omeralaa11/BLDC-Motor-controller-for-Shell-eco-marathon-/README.md

# BLDC-Motor-controller-for-Shell-eco-marathon-
Hardware design of A BLDC Motor controller design for a 350W motor used in Shell eco marathon Qatar 2026 competition
