omeralaa11/BLDC-Motor-controller-for-Shell-eco-marathon-/REF/Ref designs for controller hardware.docx

Ref designs for shell controller hardware

- https://github.com/pgrady3/EasyController3/tree/main
- https://vesc-project.com/
- https://odriverobotics.com/
- https://github.com/HugoBrunner/E-Comet-Software-for-Shell-Eco-Marathon/tree/master
- https://github.com/AlkaMotors/f051bldc
- https://github.com/pgrady3/EasyController2
- https://github.com/EFeru/hoverboard-firmware-hack-FOC?tab=readme-ov-file#hardware
- https://www.youtube.com/watch?v=Rgaq5ax71fE
- https://simple-circuit.com/arduino-brushless-dc-motor-controller/
- https://www.mouser.com/pdfDocs/Essential_Guide_to_Brushless_DC_Motor_Controls041921.pdf
- https://thinkrobotics.com/blogs/learn/bldc-motor-controller-design-complete-engineering-guide-for-brushless-dc-motor-controllers-in-2025
- https://www.integrasources.com/blog/bldc-motor-controller-design-principles/
- https://resources.altium.com/p/build-advanced-brushless-motor-controller
- https://www.elektormagazine.com/articles/a-beginner-s-guide-to-controlling-bldc-motors
- https://www.instructables.com/Make-Your-Own-Sensored-ESC/
