omeralaa11/BLDC-Motor-controller-for-Shell-eco-marathon-/Images & Pics/Controller V2_2.jpg

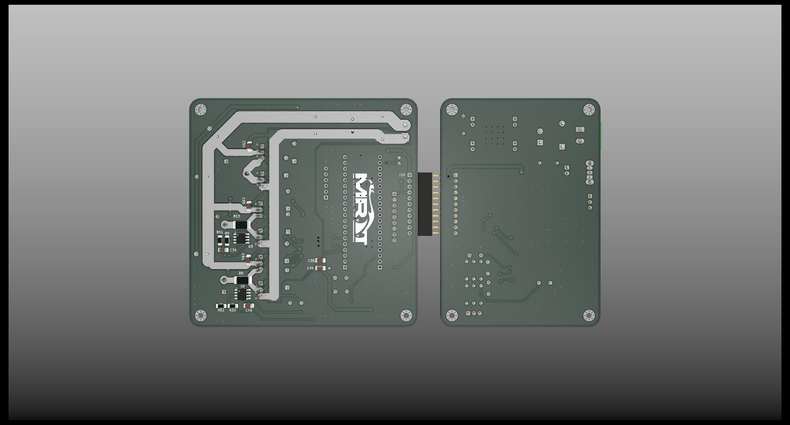
Images & Pics/Controller V2_2.jpg
