omeralaa11/BLDC-Motor-controller-for-Shell-eco-marathon-/Images & Pics/WhatsApp Image 2026-02-10 at 7.59.01 PM (1).jpeg

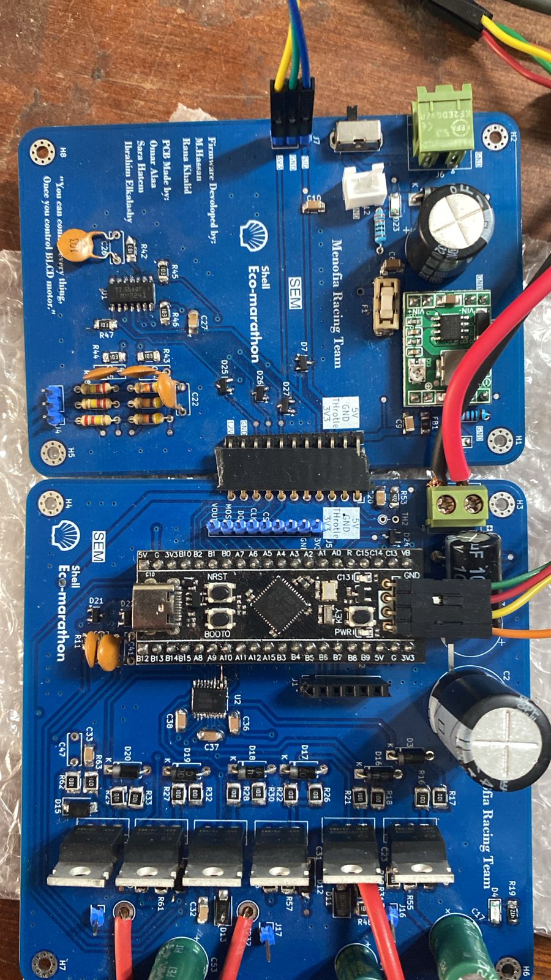
Images & Pics/WhatsApp Image 2026-02-10 at 7.59.01 PM (1).jpeg
