omeralaa11/BLDC-Motor-controller-for-Shell-eco-marathon-/3D models/D-SUN_dcdc_step_down_SIMPLE.step

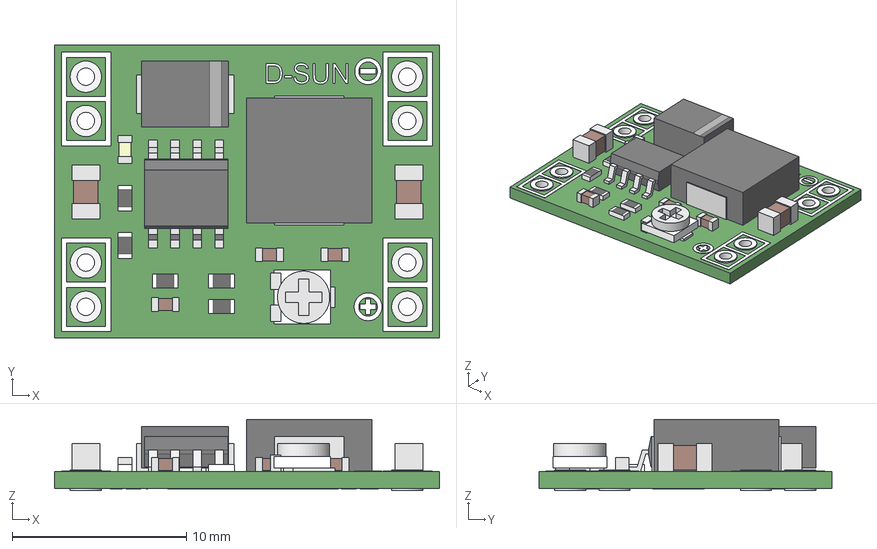
[picture p17: CAD file, 2026-03-26]
3D models/D-SUN_dcdc_step_down_SIMPLE.step
22.1 x 16.8 x 4.10 mm
main001
silk-TOP
pins
silk-bot
comp-top
