omeralaa11/BLDC-Motor-controller-for-Shell-eco-marathon-/3D models/SMD fuse holder v7.step

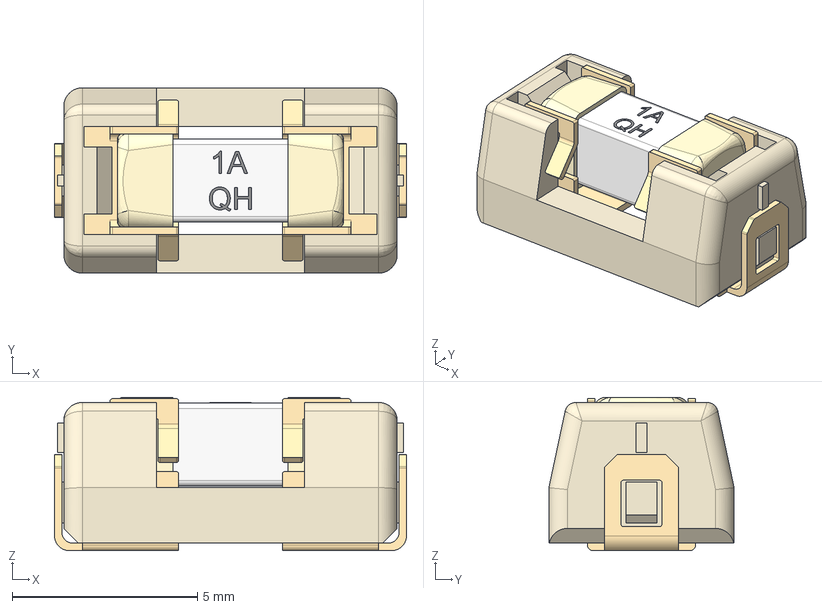
[picture p18: CAD file, 2026-03-26]
3D models/SMD fuse holder v7.step
9.50 x 5.00 x 4.14 mm
0679H1000-xxsingle fonts v2
Terminal
