omeralaa11/BLDC-Motor-controller-for-Shell-eco-marathon-/3D models/DRV8300DPWR.step

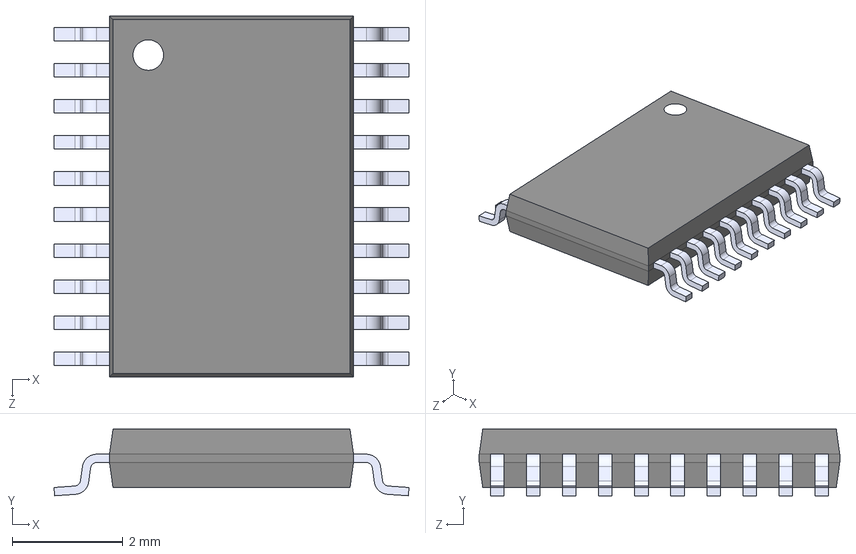
[picture p19: CAD file, 2026-03-26]
3D models/DRV8300DPWR.step
6.40 x 1.20 x 6.50 mm
