omeralaa11/BLDC-Motor-controller-for-Shell-eco-marathon-/3D models/703W-00_52.step

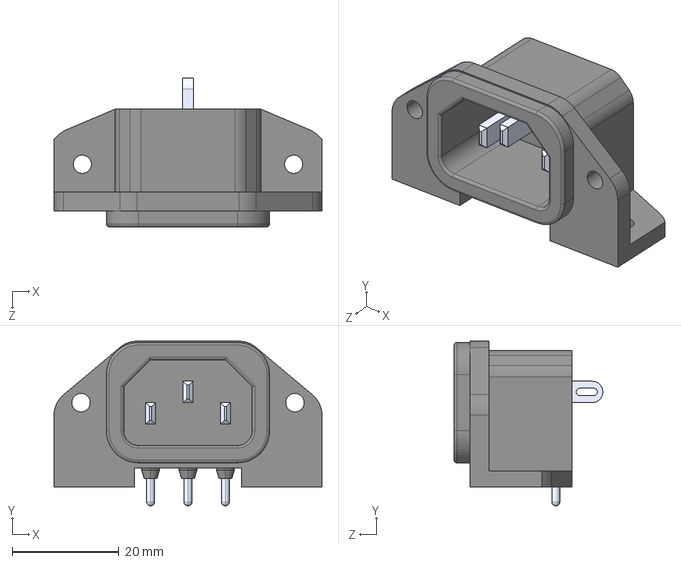
[picture p20: CAD file, 2026-03-26]
3D models/703W-00_52.step
50.1 x 30.8 x 27.8 mm
