omeralaa11/BLDC-Motor-controller-for-Shell-eco-marathon-/3D models/Controller V2.step

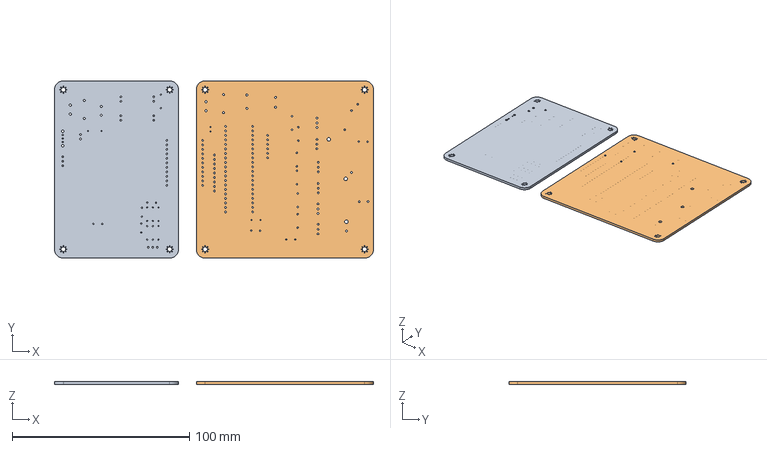
[picture p21: CAD file, 2026-03-26]
3D models/Controller V2.step
180.0 x 100.0 x 1.51 mm
Controller V2_PCB_1
Controller V2_PCB_2
