omeralaa11/BLDC-Motor-controller-for-Shell-eco-marathon-/3D models/DRV8303DCA.step

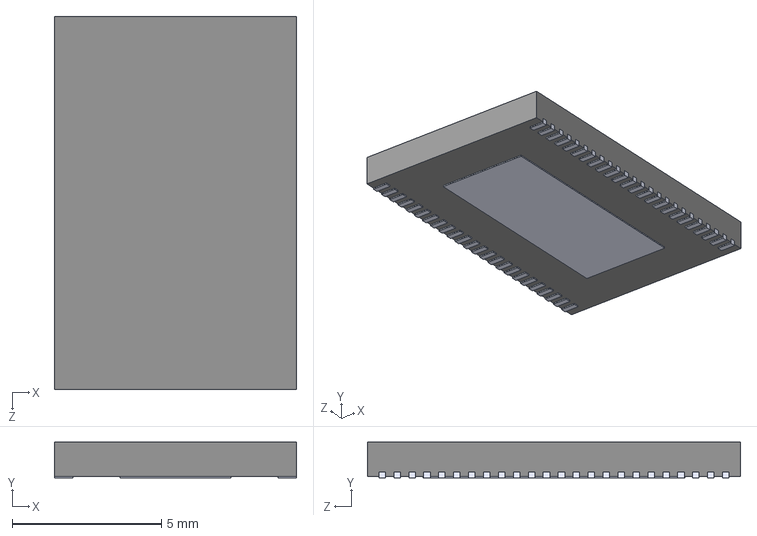
[picture p22: CAD file, 2026-03-26]
3D models/DRV8303DCA.step
8.10 x 1.20 x 12.5 mm
