omeralaa11/BLDC-Motor-controller-for-Shell-eco-marathon-/Documents/Controller  V2.pdf

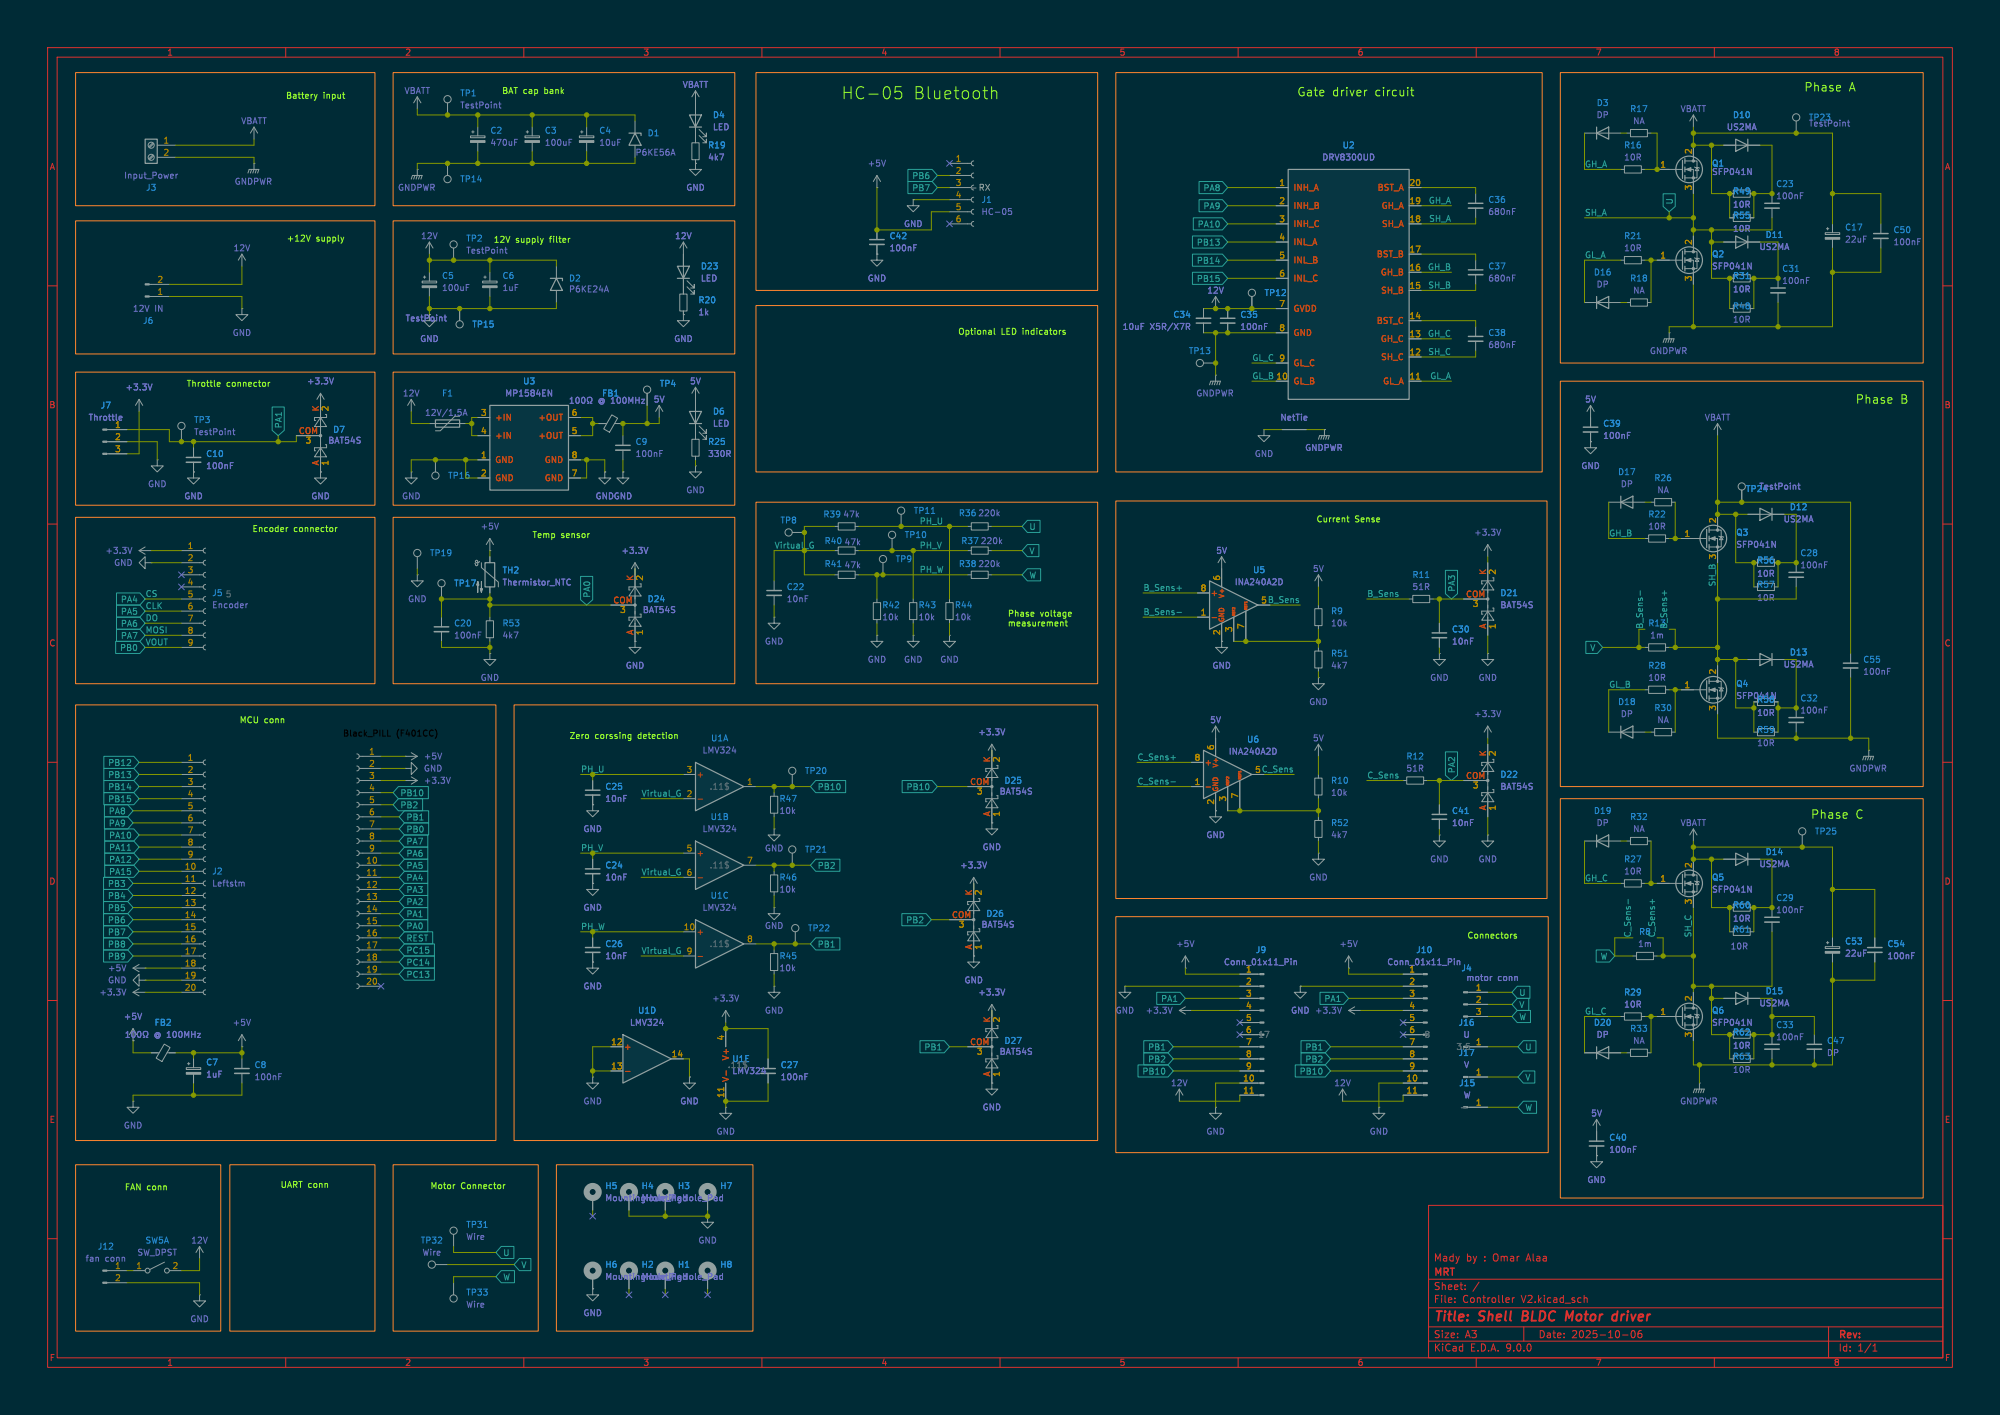
[picture p23: page 1]

Temp sensor Motor Connector
