omeralaa11/BLDC-Motor-controller-for-Shell-eco-marathon-/(list of files, drawings)

Other design files:
Simulation & analysis/code_test0.pdsprj
Simulation & analysis/Current Sensor new2.pdsprj
Simulation & analysis/Current Sensor new.pdsprj
Simulation & analysis/dead time.pdsprj
Simulation & analysis/Zero Crossing Simulation2.pdsprj
Simulation & analysis/Zero Crossing Simulation.pdsprj
