omeralaa11/BLDC-Motor-controller-for-Shell-eco-marathon-/PCB/Controller V2.kicad_sch

## KiCad design PCB/Controller V2.kicad_sch (2026-03-26)

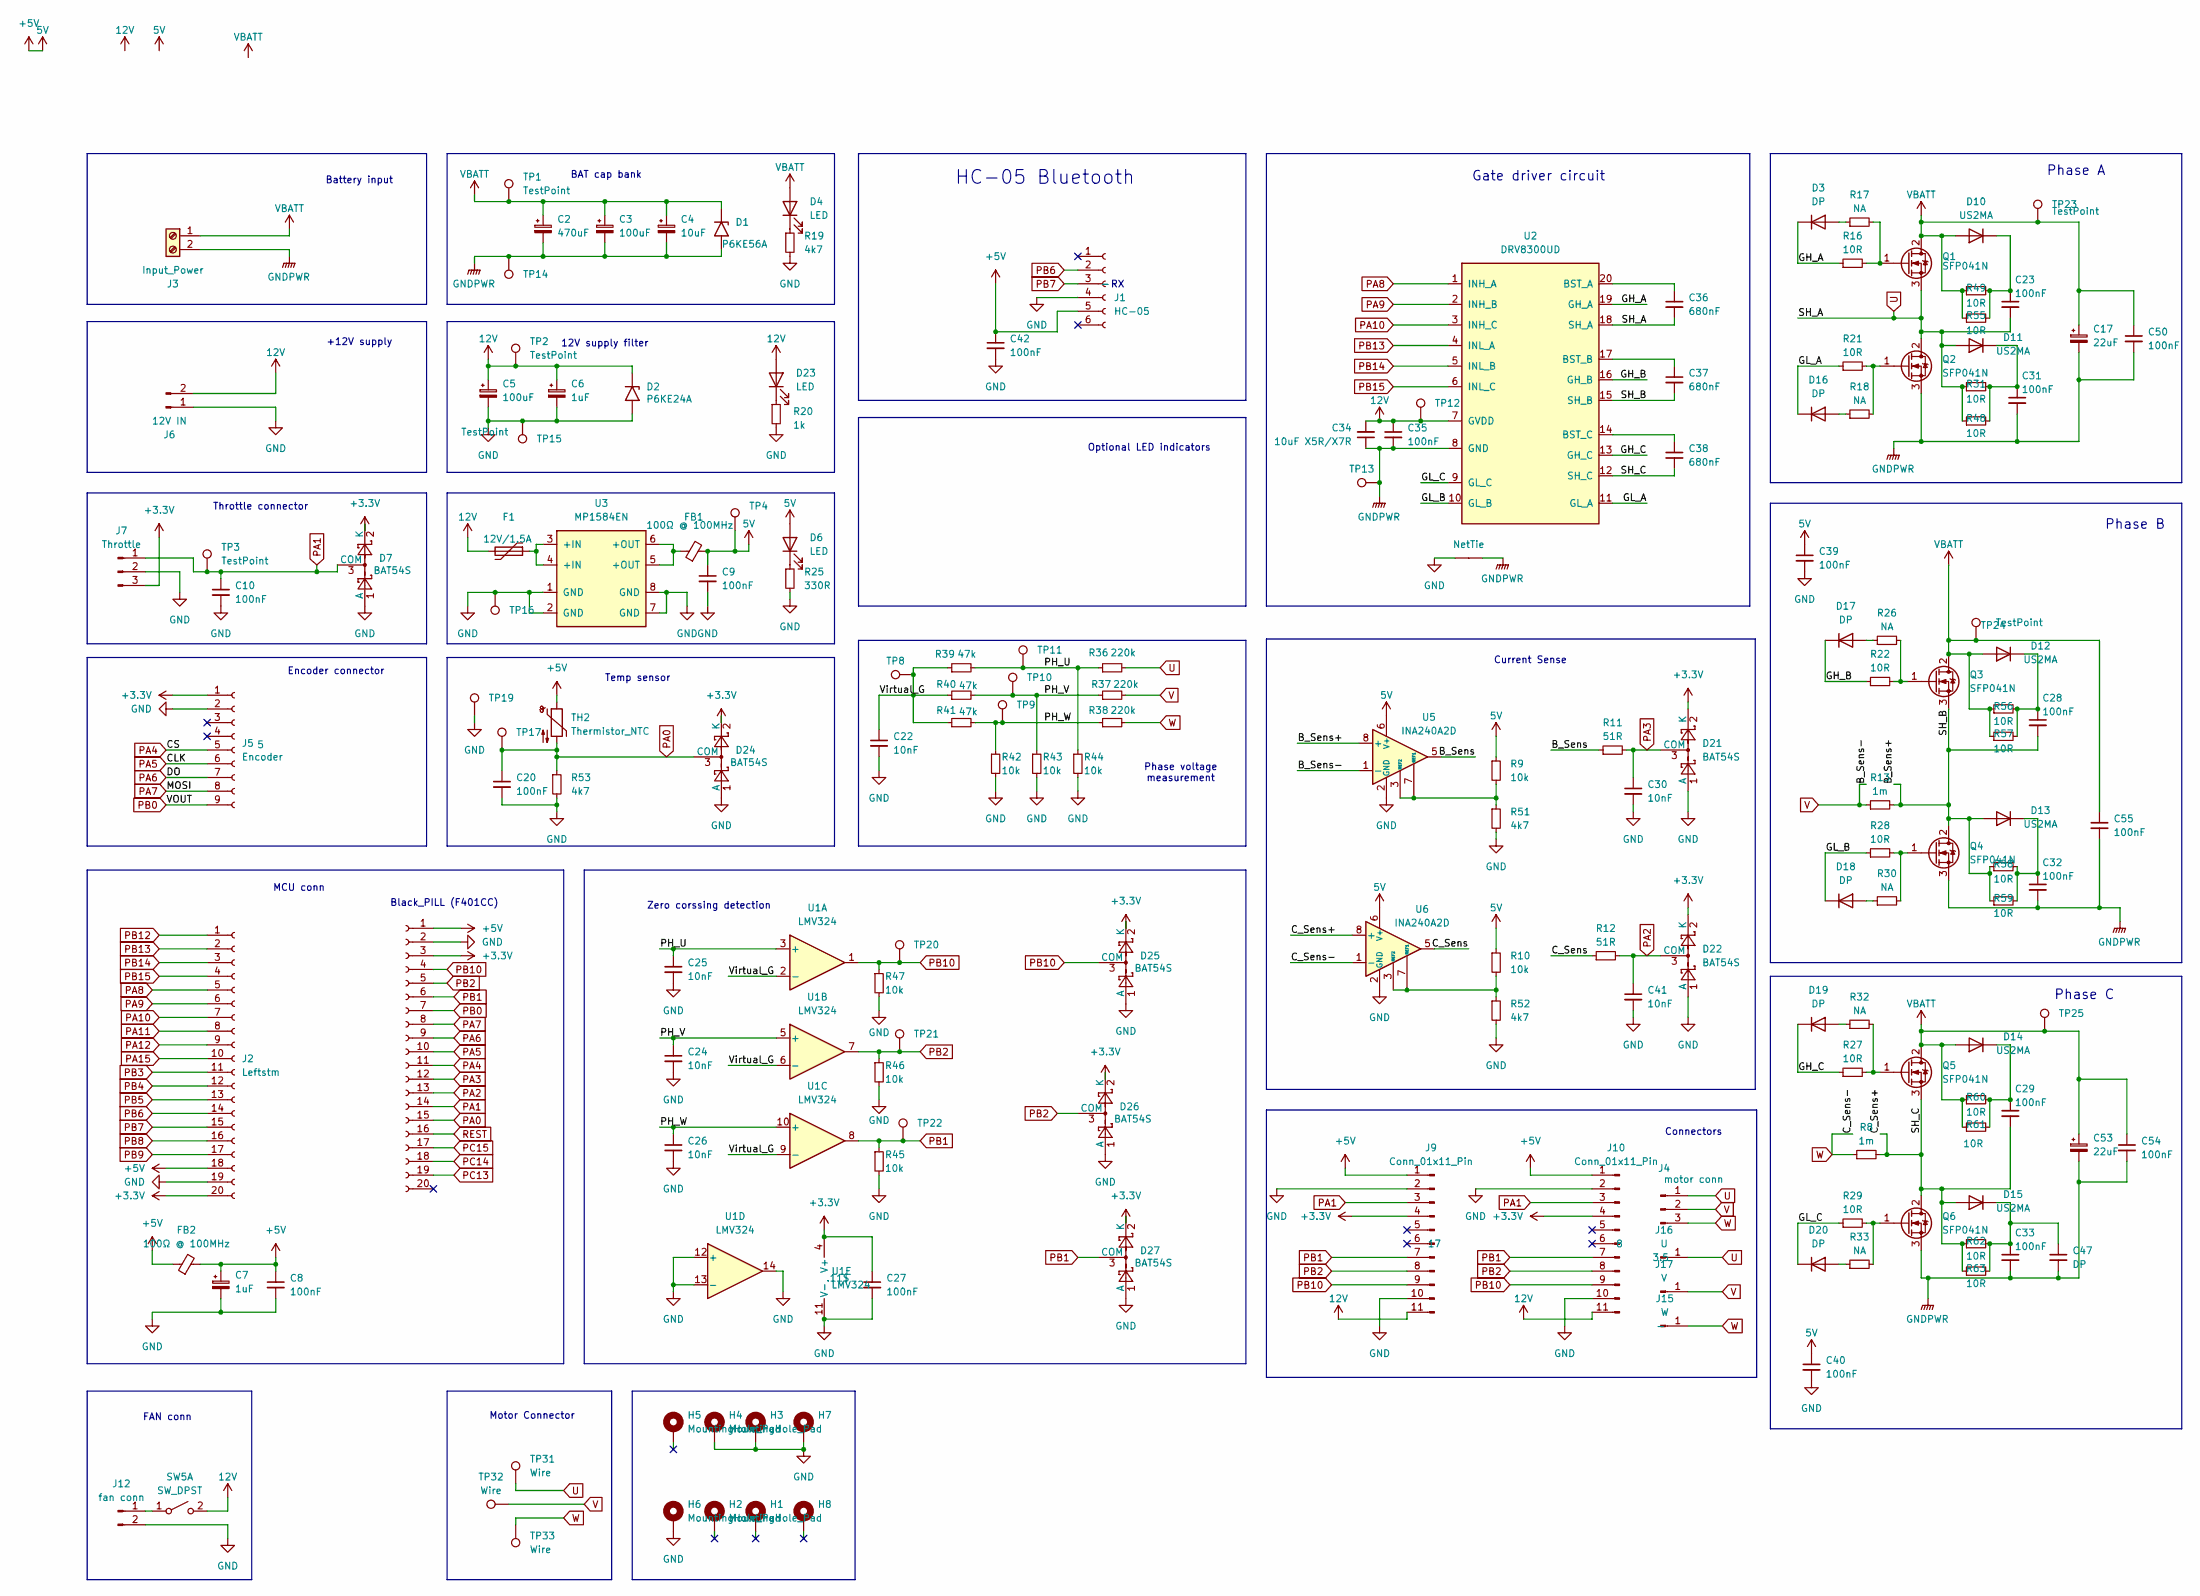
[picture p24: schematic Controller V2.kicad_sch]

Parts:
C2: 470uF; CP_Radial_D16.0mm_P7.50mm
C3, C5: 100uF; CP_Radial_D12.5mm_P5.00mm
C4: 10uF; CP_Radial_D8.0mm_P5.00mm
C6, C7: 1uF; C_1206_3216Metric_Pad1.33x1.80mm_HandSolder
C8, C9, C10, C20, C23, C27, C28, C29, C31, C32, C33, C35, C39, C40, C42, C50, C54, C55: 100nF; C_1206_3216Metric_Pad1.33x1.80mm_HandSolder
C17, C53: 22uF; CP_Radial_D10.0mm_P5.00mm
C22, C24, C25, C26, C30, C41: 10nF; C_Disc_D6.0mm_W2.5mm_P5.00mm
C34: 10uF X5R/X7R; C_1206_3216Metric_Pad1.33x1.80mm_HandSolder
C36, C37, C38: 680nF; C_1206_3216Metric_Pad1.33x1.80mm_HandSolder
C47: DP; C_Disc_D6.0mm_W2.5mm_P5.00mm
D1: P6KE56A; D_DO-15_P10.16mm_Horizontal
D2: P6KE24A; D_DO-15_P10.16mm_Horizontal
D3, D16, D17, D18, D19, D20: DP; D_A-405_P7.62mm_Horizontal
D4, D6, D23: LED; LED_1206_3216Metric_Pad1.42x1.75mm_HandSolder
D7, D21, D22, D24, D25, D26, D27: BAT54S; SOT-23
D10, D11, D12, D13, D14, D15: US2MA; D_SMA
F1: 12V/1.5A; Fuse_2512_6332Metric
FB1, FB2: 100Ω @ 100MHz; L_1206_3216Metric_Pad1.42x1.75mm_HandSolder
H1, H2, H3, H4, H5, H6, H7, H8: MountingHole_Pad; MountingHole_2.5mm_Pad_Via
J1: HC-05; PinSocket_1x06_P2.54mm_Vertical
J2, J11: Leftstm; PinSocket_1x20_P2.54mm_Vertical
J3: Input_Power; TerminalBlock_Phoenix_MKDS-1,5-2-5.08_1x02_P5.08mm_Horizont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
J4: motor conn; PinHeader_1x03_P2.54mm_Vertical
J5: Encoder; PinHeader_1x09_P2.54mm_Vertical
J6: 12V IN; PhoenixContact_MSTBA_2,5_2-G-5,08_1x02_P5.08mm_Horizontal
J7: Throttle; PinHeader_1x03_P2.54mm_Vertical
J9: Conn_01x11_Pin; PinHeader_1x11_P2.54mm_Horizontal
J10: Conn_01x11_Pin; PinSocket_1x11_P2.54mm_Horizontal
J12: fan conn; JST_EH_B2B-EH-A_1x02_P2.50mm_Vertical
J15: W; PinHeader_1x01_P2.54mm_Vertical
J16: U; PinHeader_1x01_P2.54mm_Vertical
J17: V; PinHeader_1x01_P2.54mm_Vertical
NT1: NetTie; NetTie-2_SMD_Pad0.16mm_6mil; Part Number Do Not Place
Q1, Q2, Q3, Q4, Q5, Q6: SFP041N; TO-220-3_Vertical; Part Number 2 IRFB7545PBF
R8, R13: 1m; R_2512_6332Metric_Pad1.40x3.35mm_HandSolder
R9, R10, R42, R43, R44, R45, R46, R47: 10k; R_1206_3216Metric_Pad1.30x1.75mm_HandSolder
R11, R12: 51R; R_0805_2012Metric_Pad1.20x1.40mm_HandSolder
R16, R21, R22, R27, R28, R29, R31, R48, R49, R55, R56, R57, R58, R59, R60, R61, R62, R63: 10R; R_1210_3225Metric_Pad1.30x2.65mm_HandSolder
R17, R18, R26, R30, R32, R33: NA; R_1210_3225Metric_Pad1.30x2.65mm_HandSolder
R19, R51, R52, R53: 4k7; R_1206_3216Metric_Pad1.30x1.75mm_HandSolder
R20: 1k; R_Axial_DIN0204_L3.6mm_D1.6mm_P7.62mm_Horizontal
R25: 330R; R_Axial_DIN0204_L3.6mm_D1.6mm_P7.62mm_Horizontal
R36, R37, R38: 220k; R_Axial_DIN0204_L3.6mm_D1.6mm_P7.62mm_Horizontal
R39, R40, R41: 47k; R_Axial_DIN0204_L3.6mm_D1.6mm_P7.62mm_Horizontal
SW5: SW_DPST; SW_Slide_SPDT_Straight_CK_OS102011MS2Q
TH2: Thermistor_NTC; R_Axial_DIN0204_L3.6mm_D1.6mm_P2.54mm_Vertical
TP1, TP2, TP3, TP4, TP8, TP9, TP10, TP11, TP12, TP13, TP14, TP15, TP16, TP17, TP19, TP20, TP21, TP22, TP23, TP24, TP25: TestPoint; TestPoint-1.0mm
TP31, TP32, TP33: Wire; TestPoint_Loop_D3.80mm_Drill2.0mm
U1: LMV324; SOIC-14_3.9x8.7mm_P1.27mm
U2: DRV8300UD; SOP65P640X120-20N
U3: MP1584EN; SOP65P640X120-20N
U5, U6: INA240A2D; SOIC-8_3.9x4.9mm_P1.27mm

Connections:
12V: C5.1, C6.1, C34.2, C35.1, D2.1 (A1), D23.2 (A), F1.2, J6.2, J9.11, J10.11, SW5.2 (B), TP2.1, TP12.1, U2.7 (GVDD)
+3.3V: C27.1, D7.2 (K), D21.2 (K), D22.2 (K), D24.2 (K), D25.2 (K), D26.2 (K), D27.2 (K), J2.20, J5.1, J7.3, J9.4, J10.4, J11.3, U1.4 (V+)
+5V: C7.1, C8.1, C9.1, C39.1, C40.1, C42.1, D6.2 (A), FB1.2, FB2.1, FB2.2, J1.5, J2.18, J9.1, J10.1, J11.1, R9.1, R10.1, TH2.1, TP4.1, U5.6 (V+), U6.6 (V+)
B_Sens: R11.1, U5.5
B_Sens+: C28.2, C37.2, D13.2 (A), Q3.3 (S), Q4.2 (D), R13.2, R58.1, R59.1, U2.15 (SH_B), U5.8 (+)
C_Sens: R12.1, U6.5
C_Sens+: C29.2, C38.2, D15.2 (A), Q5.3 (S), Q6.2 (D), R8.2, R62.1, R63.1, U2.12 (SH_C), U6.8 (+)
GH_A: D3.1 (K), R16.1, U2.19 (GH_A)
GH_B: D17.1 (K), R22.1, U2.16 (GH_B)
GH_C: D19.1 (K), R27.1, U2.13 (GH_C)
GL_A: D16.1 (K), R21.1, U2.11 (GL_A)
GL_B: D18.1 (K), R28.1, U2.10 (GL_B)
GL_C: D20.1 (K), R29.1, U2.9 (GL_C)
GND: C5.2, C6.2, C7.2, C8.2, C9.2, C10.2, C20.2, C22.2, C24.2, C25.2, C26.2, C27.2, C30.2, C39.2, C40.2, C41.2, C42.2, D2.2 (A2), D7.1 (A), D21.1 (A), D22.1 (A), D24.1 (A), D25.1 (A), D26.1 (A), D27.1 (A), H3.1, H4.1, H6.1, H7.1, J1.4, J2.19, J5.2, J6.1, J7.2, J9.2, J9.10, J10.2, J10.10, J11.2, J12.2, NT1.1, R19.2, R20.2, R25.2, R42.2, R43.2, R44.2, R45.2, R46.2, R47.2, R51.2, R52.2, R53.2, TP15.1, TP16.1, TP19.1, U1.11 (V-), U1.12 (+), U1.13 (-), U1.14, U3.1 (GND), U3.2 (GND), U3.7 (GND), U3.8 (GND), U5.2 (GND), U5.4 (GND), U6.2 (GND), U6.4 (GND)
GNDPWR: C2.2, C3.2, C4.2, C17.2, C31.2, C32.2, C33.2, C34.1, C35.2, C47.2, C50.2, C53.2, C54.2, C55.2, D1.2 (A2), J3.2, NT1.2, Q2.3 (S), Q4.3 (S), Q6.3 (S), TP13.1, TP14.1, U2.8 (GND)
unnamed: C23.1, D10.1 (K), R49.2, R55.2
unnamed: C28.1, D12.1 (K), R56.2, R57.2
unnamed: C29.1, D14.1 (K), R60.2, R61.2
unnamed: C31.1, D11.1 (K), R31.2, R48.2
unnamed: C32.1, D13.1 (K), R58.2, R59.2
unnamed: C33.1, C47.1, D15.1 (K), R62.2, R63.2
unnamed: C36.1, U2.20 (BST_A)
unnamed: C37.1, U2.17 (BST_B)
unnamed: C38.1, U2.14 (BST_C)
unnamed: D3.2 (A), R17.1
unnamed: D4.1 (K), R19.1
unnamed: D6.1 (K), R25.1
unnamed: D16.2 (A), R18.1
unnamed: D17.2 (A), R26.1
unnamed: D18.2 (A), R30.1
unnamed: D19.2 (A), R32.1
unnamed: D20.2 (A), R33.1
unnamed: D23.1 (K), R20.1
unnamed: F1.1, U3.3 (+IN), U3.4 (+IN)
unnamed: FB1.1, U3.5 (+OUT), U3.6 (+OUT)
unnamed: J12.1, SW5.1 (A)
unnamed: Q1.1 (G), R16.2, R17.2
unnamed: Q2.1 (G), R18.2, R21.2
unnamed: Q3.1 (G), R22.2, R26.2
unnamed: Q4.1 (G), R28.2, R30.2
unnamed: Q5.1 (G), R27.2, R32.2
unnamed: Q6.1 (G), R29.2, R33.2
unnamed: R10.2, R52.1, U6.3 (REF2), U6.7 (REF1)
unnamed: R9.2, R51.1, U5.3 (REF2), U5.7 (REF1)
PA0: C20.1, D24.3 (COM), J11.15, R53.1, TH2.2, TP17.1
PA1: C10.1, D7.3 (COM), J7.1, J9.3, J10.3, J11.14, TP3.1
PA2: C41.1, D22.3 (COM), J11.13, R12.2
PA3: C30.1, D21.3 (COM), J11.12, R11.2
PA4: J5.5, J11.11
PA5: J5.6, J11.10
PA6: J5.7, J11.9
PA7: J5.8, J11.8
PA8: J2.5, U2.1 (INH_A)
PA9: J2.6, U2.2 (INH_B)
PA10: J2.7, U2.3 (INH_C)
PA11: J2.8
PA12: J2.9
PA15: J2.10
PB0: J5.9, J11.7
PB1: D27.3 (COM), J9.7, J10.7, J11.6, R45.1, TP22.1, U1.8
PB2: D26.3 (COM), J9.8, J10.8, J11.5, R46.1, TP21.1, U1.7
PB3: J2.11
PB4: J2.12
PB5: J2.13
PB6: J1.2, J2.14
PB7: J1.3, J2.15
PB8: J2.16
PB9: J2.17
PB10: D25.3 (COM), J9.9, J10.9, J11.4, R47.1, TP20.1, U1.1
PB12: J2.1
PB13: J2.2, U2.4 (INL_A)
PB14: J2.3, U2.5 (INL_B)
PB15: J2.4, U2.6 (INL_C)
PC13: J11.19
PC14: J11.18
PC15: J11.17
PH_U: C25.1, R36.1, R39.2, R44.1, TP11.1, U1.3 (+)
PH_V: C24.1, R37.1, R40.2, R43.1, TP10.1, U1.5 (+)
PH_W: C26.1, R38.1, R41.2, R42.1, TP9.1, U1.10 (+)
REST: J11.16
U: C23.2, C36.2, D11.2 (A), J4.1, J16.1, Q1.3 (S), Q2.2 (D), R31.1, R36.2, R48.1, TP31.1, U2.18 (SH_A)
V: J4.2, J17.1, R13.1, R37.2, TP32.1, U5.1 (-)
VBATT: C2.1, C3.1, C4.1, C17.1, C50.1, C53.1, C54.1, C55.1, D1.1 (A1), D4.2 (A), D10.2 (A), D12.2 (A), D14.2 (A), J3.1, Q1.2 (D), Q3.2 (D), Q5.2 (D), R49.1, R55.1, R56.1, R57.1, R60.1, R61.1, TP1.1, TP23.1, TP24.1, TP25.1
Virtual_G: C22.1, R39.1, R40.1, R41.1, TP8.1, U1.2 (-), U1.6 (-), U1.9 (-)
W: J4.3, J15.1, R8.1, R38.2, TP33.1, U6.1 (-)

Notes on the sheet:
12V supply filter
Optional LED indicators
BAT cap bank
Phase voltage measurement
Motor Connector
FAN conn
Black_PILL (F401CC)
Zero corssing detection
Phase C
Gate driver circuit
Encoder connector
Phase A
Battery input
+12V supply
Temp sensor
MCU conn
Current Sense
Phase B
Throttle connector
HC-05 Bluetooth
Connectors
